Arve2/Vibra-trickler-2/(list of files, cad)

Other CAD files:
3D-parts/Loadbeam-end-block.3mf
3D-parts/Powdercontainer-and-baffle.3mf
3D-parts/Powderpan-holder.3mf
3D-parts/HX711-fixture.3mf
3D-parts/HX711-fixture.f3d
3D-parts/Loadbeam-end-block.f3d
3D-parts/Powdercontainer-and-baffle.f3d
3D-parts/Powderpan-holder.f3d
