Arve2/Vibra-trickler-2/(commit log)

2024-07-02 LFS track media and 3D file types
2024-07-06 Images for circuit and GUIs
2024-07-07 Image for assembly of load cell and HX711
2024-07-08 hx-start.py driver script
2024-07-08 Main Node-RED flow
2024-07-15 Complete Bill Of Materials
    This concludes issue #2
